davidpalma666/Miniscope-v4-Wire-Free-FORK/Miniscope-v4-Wire-Free-KiCad/KiCad/Miniscope-v4-Wire-Free BOM 1st COMPLETE.xlsx

Miniscope-v4-Wire-Free BOM
 | Qty | Reference | Value | Description | MPN | OEPS PN | Footprint
 | 9 | C1, C2, C6, C7, C26, C35, C50-C52 | 10uF | SMD CER 0402 10uF 10V ±20% X5R (OEPS M01 014) | CL05A106MP5NUNC | OEPS010038 | .Capacitor:C_0402_1005Metric_L
 | 2 | C14, C37 | 1uF | SMD CER 0201 1uF 16V ±20% X5R (OEPS M01 009) | CL03A105MO3NRNH | OEPS010036 | .Capacitor:C_0201_0603Metric_L
 | 1 | C16 | 4.7nF 100V | SMD CER 0603 4.7nF 100V ±10% X7R | 885012206112 _ | OEPS010014 | .Capacitor:C_0603_1608Metric_L
 | 3 | C17, C29, C36 | 4.7uF | SMD CER 0201 4.7UF 6.3V ±20% X5R CASE SIZE CONTAINS MAX VOLTAGE!! | GRM035R60J475ME15D https://www.digikey.pt/en/products/detail/murata-electronics/GRM035R60J475ME15D/5877393 | TBD | .Capacitor:C_0201_0603Metric_L
 | 2 | C18, C20 | 22pF | SMD CER 0201 27pF 50V ±2% C0G, NP0 | GRM0335C1H270GA01D | OEPS010029 | .Capacitor:C_0201_0603Metric_L
 | 2 | C3, C4 | 10pF | SMD CER 0201 10pF 50V ±5% C0G | GRM0335C1H100JA01J | OEPS010060 | .Capacitor:C_0201_0603Metric_L
 | 5 | C5, C11-C13, C15 | 2.2uF | SMD CER 0201 2.2uF 10V ±20% X5R (OEPS J05 004A) | CM03X5R225M10AH | OEPS010042 | .Capacitor:C_0201_0603Metric_L
 | 22 | C9, C10, C19, C22-C25, C27, C28, C30, C38, C40-C49, C53 | 0.1uF | SMD CER 0201 100nF 25V ±10% X5R (OEPS M01 007) | GRM033R61E104KE14J | OEPS010035 | .Capacitor:C_0201_0603Metric_L
 | 1 | D1 | LXZ1-PR01 | LED SMD Blue 450nm 500mA (OEPS J05 012) | LXZ1-PR01 | OEPS030021 | .LED:LED_LXZ1_PR01_L
 | 2 | D2, D3 | LED_Small_ALT | !!! Wich LED PN? | !!! Wich LED PN? | !!! TBD | .LED:LED_SC80X160X65L40L
 | 1 | J1 | 475710001 | CONN MICRO SD CARD PUSH-PULL R/A | 0475710001 https://www.digikey.com/en/products/detail/molex/0475710001/3262277 | TBD | .Connector:0475710001
 | 1 | J2 | Conn_01x04 | !!! Which connector PN? | !!! Which connector PN? | !!! TBD | .Connector:1x4_USB
 | 1 | J3 | Conn_01x04 | CONN FFC BOTTOM 4POS 0.5MM R/A | FH19C-4S-0.5SH(10) | TBD | .Connector:FH19C-4S-0.5SH(10)
 | 23 | J4-J12, J14-J27 | Conn_01x01 | !!! Which connector PN? | !!! Which connector PN? | !!! TBD | .Connector:Conn_1x1_700_Circular_Pad
 | 2 | L1, L5 | 10uH | FIXED IND 10UH 400MA 2.7 OHM SMD | 0805CT-103EKFS https://www.digikey.pt/en/products/detail/delta-electronics-components/0805CT-103EKFS/9764104 | TBD | .Capacitor:C_0805_2012Metric_L
 | 1 | L2 | 4.7uH | FIXED INDUCTOR SMD 4.7uH 750mA 260mΩ | !! CIG21L4R7MNE Obsolete; to select a new one | TBD !! OEPS040017 Obsolete | .Capacitor:C_0805_2012Metric_L
 | 1 | L3 | L_Small | !!! Wich L value? | !!! Wich L value? | !!! TBD | .Inductor:L_0603_1608Metric_L
 | 1 | L4 | BLM18PG471SN1D | FERRITE BEAD SMD 470Ω 1A 200mΩ (OEPS J05 017) | BLM18PG471SN1D | OEPS040014 | .Inductor:L_0603_1608Metric_L
 | 1 | Q1 | NTK3134NT1G | Power MOSFET | NTK3134NT1G | TBD | .Transistor:TRXSOFL3P40_120X120X55L29X21L
 | 1 | Q2 | MMBT3904LP-7B | BJT NPN 40V 0.2A (OEPS J05 019) | MMBT3904LP-7B | OEPS060014 | .Transistor:TRXDFN3_101X61X53L25X15N
 | 2 | R1, R17 | 25K | !!! 25k with no components; closest value 24.9k | !!! RC0201FR-0724K9L https://www.digikey.com/en/products/detail/yageo/RC0201FR-0724K9L/3202396 | !!! TBD | .Resistor:R_0201_0603Metric_ERJ_L
 | 1 | R10 | 2K | SMD 0201 2kΩ ±1% 0.050W (OEPS Q20 006, OEPS M01 021) | RC0201FR-072KL | OEPS020067 | .Resistor:R_0201_0603Metric_ERJ_L
 | 2 | R11, R19 | 1K | SMD 0201 1kΩ ±1% 0.050W (OEPS Q20 008) | RC0201FR-071KL | OEPS020065 | .Resistor:R_0201_0603Metric_ERJ_L
 | 1 | R12 | DNL | - | - | n.a. | .Resistor:R_0201_0603Metric_ERJ_L
 | 1 | R13 | 400K | !!! 400k with no components; closest value 402k | !!! ERJ-1GNF4023C https://www.digikey.com/en/products/detail/panasonic-electronic-components/ERJ-1GNF4023C/2036409 | !!! TBD | .Resistor:R_0201_0603Metric_ERJ_L
 | 3 | R14, R16, R20 | 100K | SMD 0201 100kΩ ±1% 0.050W (OEPS J05 022) | ERJ-1GNF1003C | OEPS020072 | .Resistor:R_0201_0603Metric_ERJ_L
 | 1 | R15 | 37K | !!! 37k with no components; closest value 37.4k | !!! ERJ-1GNF3742C https://www.digikey.com/en/products/detail/panasonic-electronic-components/ERJ-1GNF3742C/2036290 | !!! TBD | .Resistor:R_0201_0603Metric_ERJ_L
 | 1 | R18 | R_Small_US | !!! Wich R value? | !!! Wich R value? | !!! TBD | .Resistor:R_0201_0603Metric_ERJ_L
 | 1 | R2 | 1K8 | SMD 0201 1.8kΩ ±1% 0.050W (OEPS J05 024) | ERJ-1GNF1801C | OEPS020074 | .Resistor:R_0201_0603Metric_ERJ_L
 | 1 | R21 | 10K | SMD 0201 10kΩ ±1% 0.050W (OEPS J05 021) | ERJ-1GNF1002C | OEPS020071 | Custom:R_0201_0603Metric_ERJ_L
 | 1 | R22 | 47k5 | SMD 0201 47.5kΩ ±1% 0.050W (OEPS J05 025) | ERJ-1GNF4752C | OEPS020075 | Custom:R_0201_0603Metric_ERJ_L
 | 1 | R3 | 1.25M | 1.25M only witn non-standard package; 1.2M - as option | CRCW02011M20FNED https://www.digikey.com/en/products/detail/vishay-dale/CRCW02011M20FNED/8637988 | TBD | .Resistor:R_0201_0603Metric_ERJ_L
 | 1 | R4 | 2.05M | SMD 0201 2.05MΩ ±1% 0.050W | CRCW02012M05FNED https://www.digikey.com/en/products/detail/vishay-dale/CRCW02012M05FNED/10458998 | TBD | .Resistor:R_0201_0603Metric_ERJ_L
 | 1 | R5 | 1M | SMD 0201 1MΩ ±1% 0.050W | CRCW02011M00FNED https://www.digikey.com/en/products/detail/vishay-dale/CRCW02011M00FNED/1178507 | TBD | .Resistor:R_0201_0603Metric_ERJ_L
 | 1 | R6 | 649K | SMD 0201 649kΩ ±1% 0.050W | RC0201FR-07649KL https://www.digikey.com/en/products/detail/yageo/RC0201FR-07649KL/5280620 | TBD | .Resistor:R_0201_0603Metric_ERJ_L
 | 2 | R7, R8 | 2.2K | SMD 0201 2.2kΩ ±1% 0.050W | RC0201FR-072K2L https://www.digikey.com/en/products/detail/yageo/RC0201FR-072K2L/5280432 | TBD | .Resistor:R_0201_0603Metric_ERJ_L
 | 1 | R9 | 8.2K | SMD 0201 8.2kΩ ±1% 0.050W | ERJ-1GNF8201C https://www.digikey.com/en/products/detail/panasonic-electronic-components/ERJ-1GNF8201C/2036216 | TBD | .Resistor:R_0201_0603Metric_ERJ_L
 | 1 | SW1 | TL3780AF330QG | SWITCH TACTILE SPST-NO 0.05A 12V | TL3780AF330QG https://www.digikey.com/en/products/detail/e-switch/tl3780af330qg/6003168 | TBD | .Switch:SMD-Switch-3mmx2mm
 | 1 | U1 | LTC3554 | IC USB POWER MANAGER 20UTQFN | LTC3554EUD#PBF https://www.digikey.com/en/products/detail/analog-devices-inc/LTC3554EUD-PBF/2355199 | TBD | Package_DFN_QFN:QFN-20-1EP_3x3mm_P0.4mm_EP1.65x1.65mm
 | 1 | U2 | HV892 | IC LED DRIVER LENS 10WDFN | HV892K7-G https://www.digikey.com/en/products/detail/microchip-technology/HV892K7-G/4902801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 | TBD | .Package_SON:SON11P65_400X400X80L40X30T315X255L
 | 1 | U3 | LTC3218 | LED Driver 150mA (OEPS J1 022) | LTC3218EDDB#TRMPBF | OEPS080069 | .Package_SON:SON_11_P50_300X200X80L40X25T239X64L
 | 1 | U4 | MAX13030EETE+BGA | !!! Which component PN? | !!! Component's value doesn't allow to know PN; MAX13031; MAX13032; MAX13033; MAX13034; MAX13035 ?? | !!! TBD | Package_BGA:BGA-16_1.92x1.92mm_Layout4x4_P0.5mm
 | 1 | U5 | TSOP57438TT1 | IR Receiver Sensor 38.0kHz 40m Surface Mount | TSOP57438TT1 | OEPSJ1008 | .Package_SON:SON_4_P300_395X395X90L55X35L
 | 1 | U6 | ATSAMD51J20A-UUT-EFP | MCU 120MHZ 1024KB FLASH 64 | ATSAMD51J20A-UUT-EFP https://www.digikey.com/en/products/detail/microchip-technology/atsamd51j20a-uut-efp/11476389 | TBD | .Package_BGA:ATSAMD51J20A-UUT-EFP
 | 1 | U7 | NCP163AMX330TBG | LDO 3.3V 250mA (OEPS Z00 004) | NCP163AMX330TBG | OEPS080076 | .Package_QFN:UQFN_MCP1711
 | 1 | U8 | NOIP1SN0480A | !!! Which component? | !!! Component's value doesn't allow to know PN; NOIP1SN0480A-STI or NOIP1SN0480A-STI1 | !!! TBD | .Package_BGA:BGA88CP50_8X11_493X613X75B25
 | 1 | U9 | LMV321IDCKR | OPAMP GP 1 CIRCUIT (OEPS J05 030) | LMV321IDCKR | OEPS080068 | .Package_SOT:SOT_23-5P65_210X110L36X22L
 | 1 | Y2 | Crystal | Which Crystal PN? | Which Crystal PN? | TBD | Crystal:Crystal_SMD_MicroCrystal_CC8V-T1A-2Pin_2.0x1.2mm
