davidpalma666/Miniscope-v4-Wire-Free-FORK/Miniscope-v4-Wire-Free-KiCad/KiCad/Miniscope-v4-Wire-Free/Miniscope-v4-Wire-Free.kicad_pcb

## KiCad design Miniscope-v4-Wire-Free-KiCad/KiCad/Miniscope-v4-Wire-Free/Miniscope-v4-Wire-Free.kicad_pcb (2025-02-11)

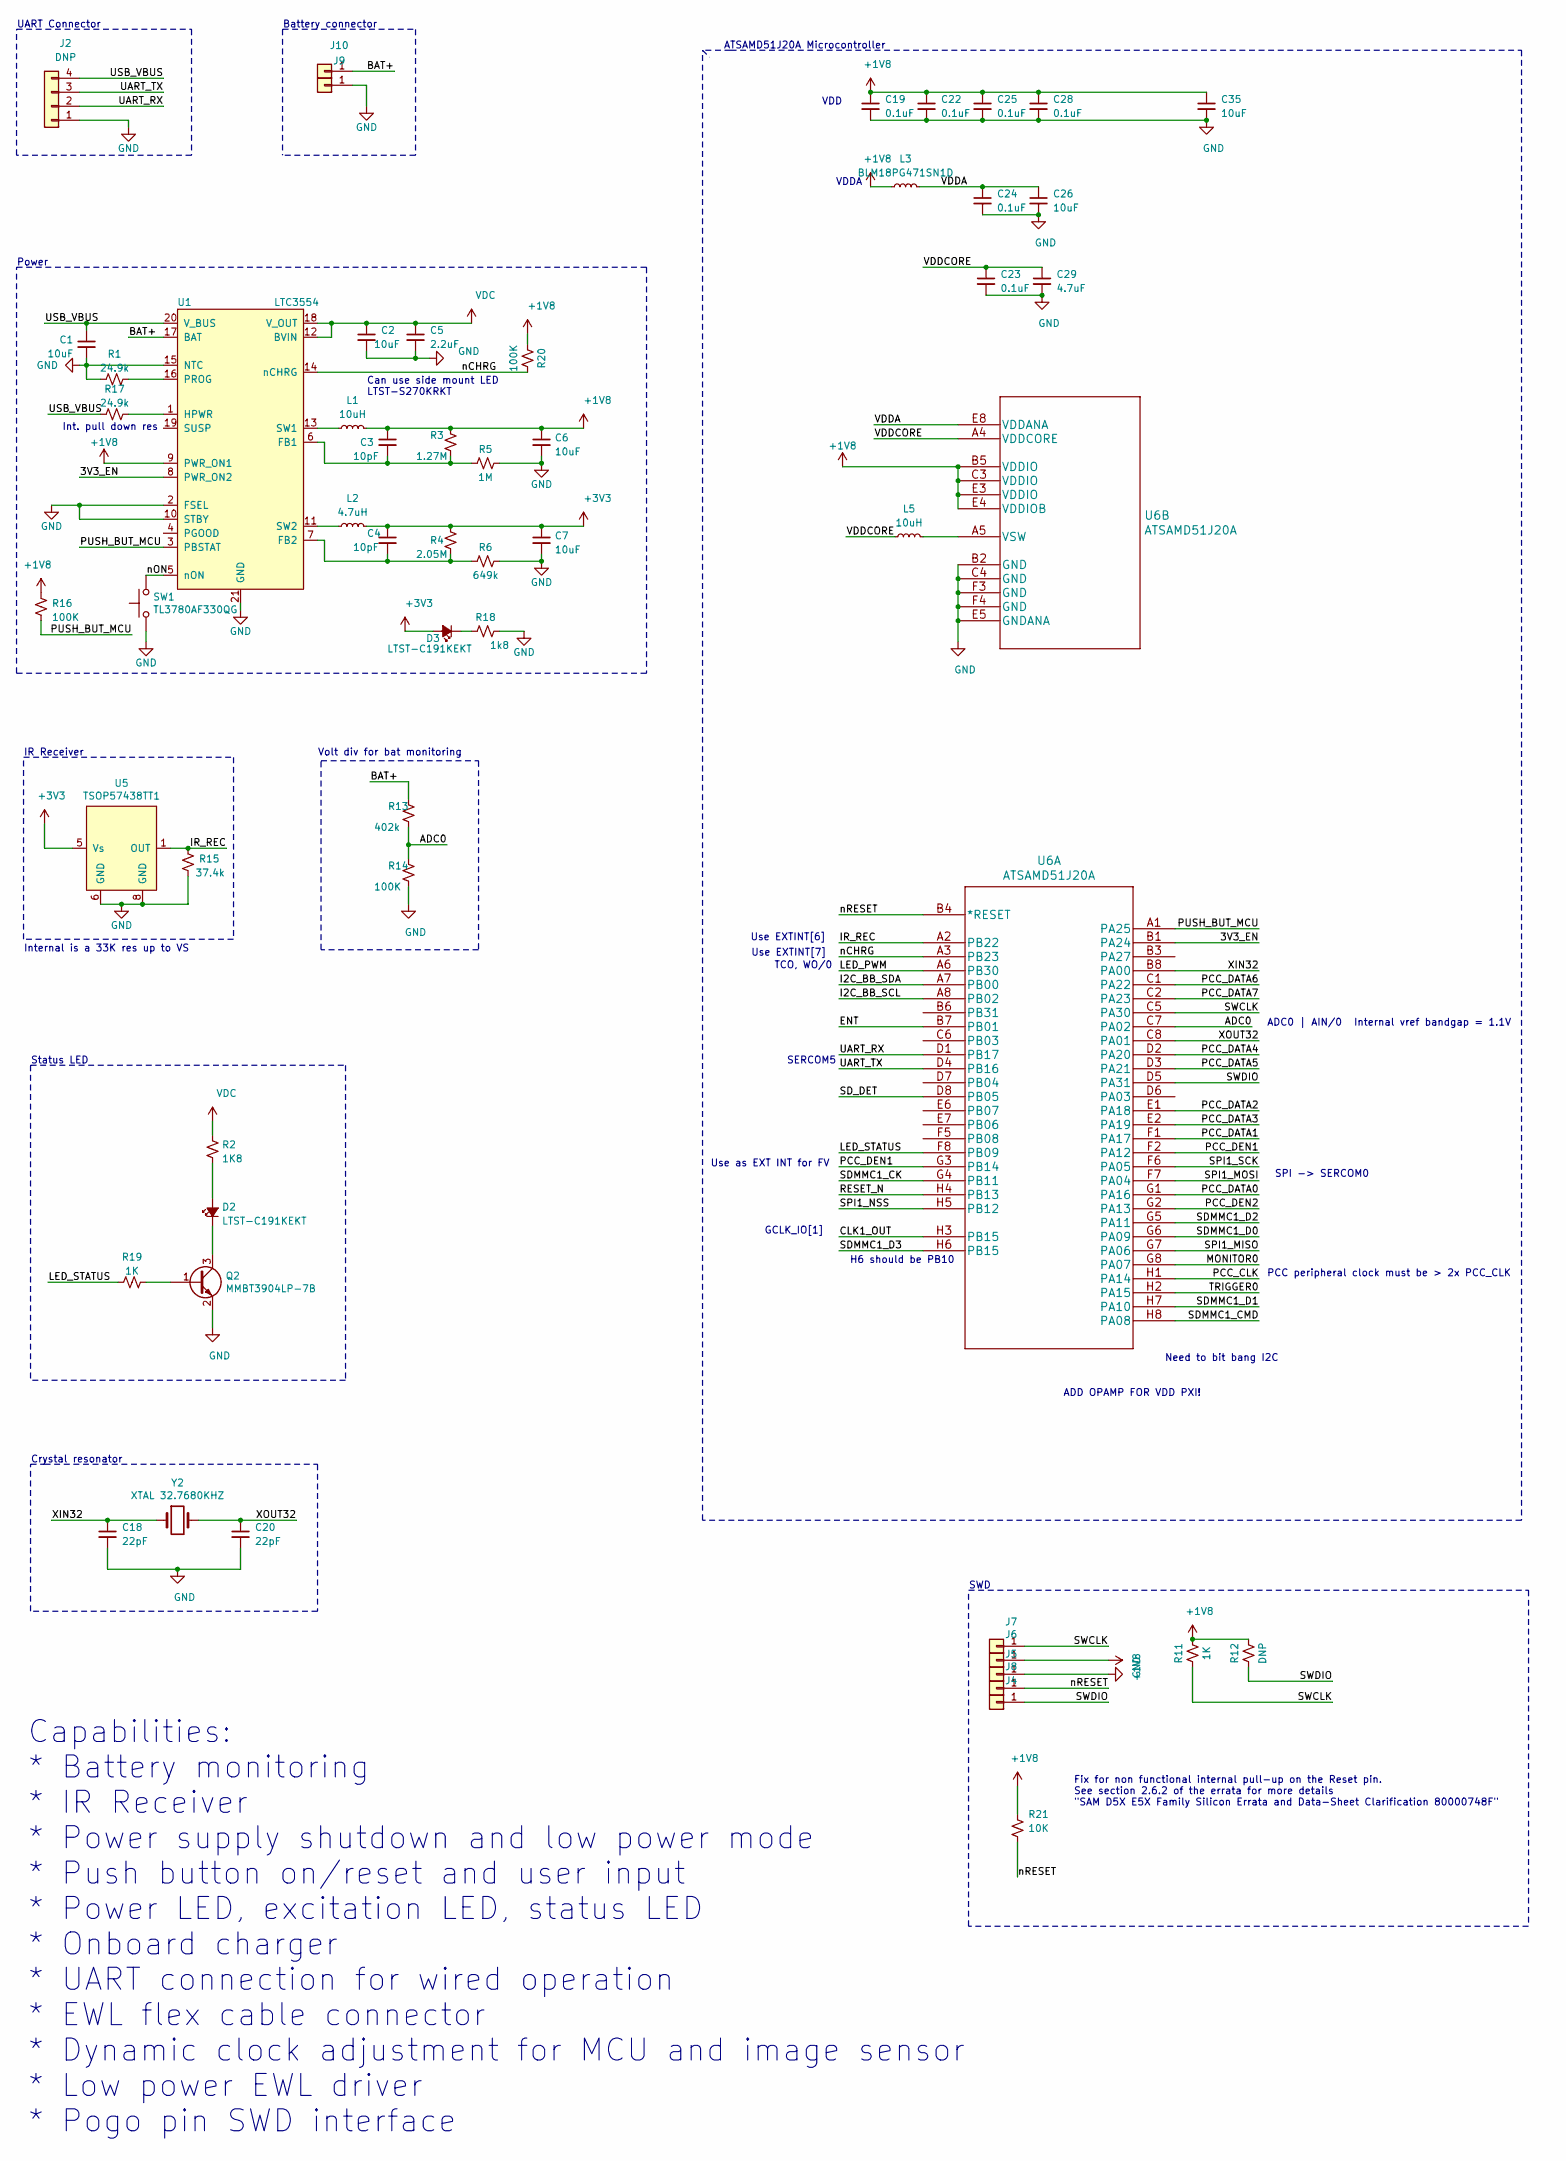
[picture p1: schematic Miniscope-v4-Wire-Free.kicad_sch, part in row 1, column 1]

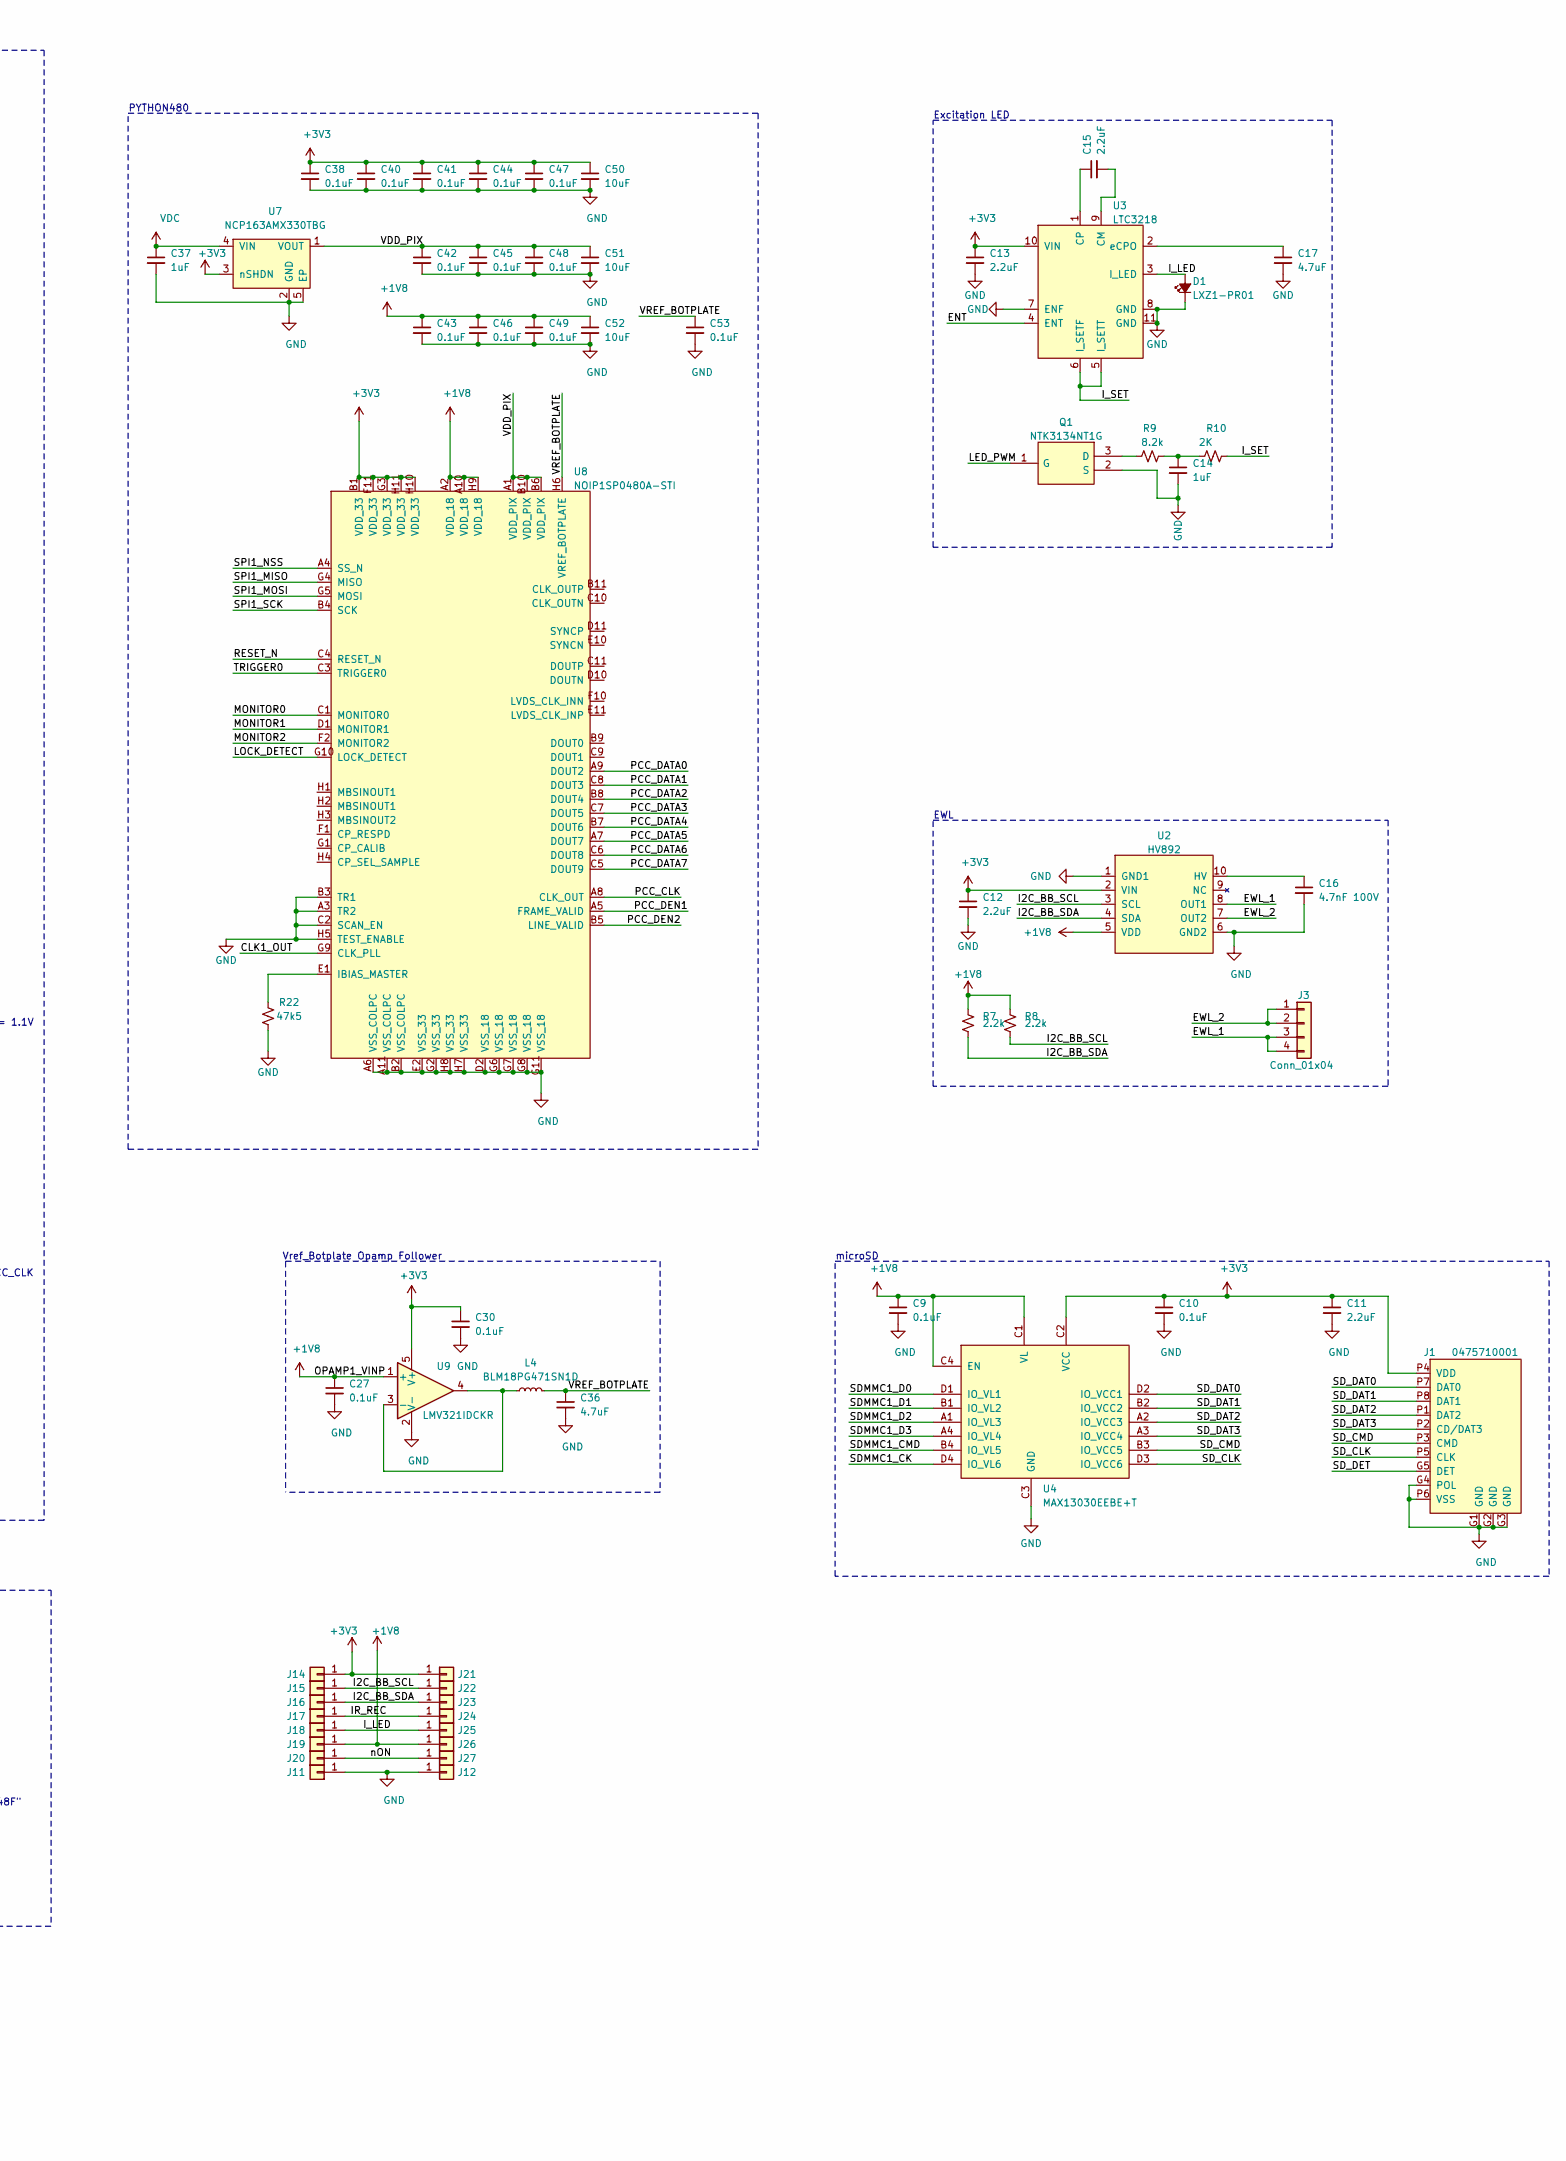
[picture p2: schematic Miniscope-v4-Wire-Free.kicad_sch, part in row 1, column 2]

Parts:
C1, C2, C6, C7, C26, C35, C50, C51, C52: 10uF; C_0402_1005Metric_L; MPN CL05A106MP5NUNC
C3, C4: 10pF; C_0201_0603Metric_L; MPN GRM0335C1H100JA01J
C5, C11, C12, C13, C15: 2.2uF; C_0201_0603Metric_L; MPN CM03X5R225M10AH
C9, C10, C19, C22, C23, C24, C25, C27, C28, C30, C38, C40, C41, C42, C43, C44, C45, C46, C47, C48, C49, C53: 0.1uF; C_0201_0603Metric_L; MPN GRM033R61E104KE14J
C14, C37: 1uF; C_0201_0603Metric_L; MPN CL03A105MO3NRNH
C16: 4.7nF 100V; C_0603_1608Metric_L; MPN 885012206112
C17, C29, C36: 4.7uF; C_0201_0603Metric_L; MPN GRM035R60J475ME15D
C18, C20: 22pF; C_0201_0603Metric_L; MPN GRM0335C1H270GA01D
D1: LXZ1-PR01; LED_LXZ1_PR01_L; MPN LXZ1-PR01
D2, D3: LTST-C191KEKT; LED_SC80X160X65L40L; MPN LTST-C191KEKT
J1: 0475710001; MPN 0475710001
J2: DNP; 1x4_USB; MPN n.a.
J3: Conn_01x04; FH19C-4S-0.5SH(10); MPN FH19C-4S-0.5SH(10)
J4, J5, J6, J7, J8, J9, J10, J11, J12, J14, J15, J16, J17, J18, J19, J20, J21, J22, J23, J24, J25, J26, J27: DNP; Conn_1x1_700_Circular_Pad; MPN n.a.
L1, L5: 10uH; C_0805_2012Metric_L; MPN MLZ1608N100LT000
L2: 4.7uH; C_0805_2012Metric_L; MPN MLP2012S4R7MT0S1
L3, L4: BLM18PG471SN1D; L_0603_1608Metric_L; MPN BLM18PG471SN1D
Q1: NTK3134NT1G; TRXSOFL3P40_120X120X55L29X21L; Manufacturer_Part_Number NTK3134NT1G; Mouser Part Number 863-NTK3134NT1G
Q2: MMBT3904LP-7B; TRXDFN3_101X61X53L25X15N; MPN MMBT3904LP-7B
R1, R17: 24.9k; R_0201_0603Metric_ERJ_L; MPN CRCW020124K9FNED
R2: 1K8; R_0201_0603Metric_ERJ_L; MPN ERJ-1GNF1801C
R3: 1.27M; R_0201_0603Metric_ERJ_L; MPN CRCW02011M27FNED
R4: 2.05M; R_0201_0603Metric_ERJ_L; MPN CRCW02012M05FNED
R5: 1M; R_0201_0603Metric_ERJ_L; MPN CRCW02011M00FNED
R6: 649k; R_0201_0603Metric_ERJ_L; MPN RC0201FR-07649KL
R7, R8: 2.2k; R_0201_0603Metric_ERJ_L; MPN RC0201FR-072K2L
R9: 8.2k; R_0201_0603Metric_ERJ_L; MPN ERJ-1GNF8201C
R10: 2K; R_0201_0603Metric_ERJ_L; MPN RC0201FR-072KL
R11, R19: 1K; R_0201_0603Metric_ERJ_L; MPN RC0201FR-071KL
R12: DNP; R_0201_0603Metric_ERJ_L; MPN n.a.
R13: 402k; R_0201_0603Metric_ERJ_L; MPN ERJ-1GNF4023C
R14, R16, R20: 100K; R_0201_0603Metric_ERJ_L; MPN ERJ-1GNF1003C
R15: 37.4k; R_0201_0603Metric_ERJ_L; MPN ERJ-1GNF3742C
R18: 1k8; R_0201_0603Metric_ERJ_L; MPN ERJ-1GNF1801C
R21: 10K; R_0201_0603Metric_ERJ_L; MPN ERJ-1GNF1002C
R22: 47k5; R_0201_0603Metric_ERJ_L; MPN ERJ-1GNF4752C
SW1: TL3780AF330QG; SMD-Switch-3mmx2mm; MPN TL3780AF330QG
U1: LTC3554; QFN-20-1EP_3x3mm_P0.4mm_EP1.65x1.65mm; MPN LTC3554EUD#PBF
U2: HV892; SON11P65_400X400X80L40X30T315X255L; MPN HV892K7-G
U3: LTC3218; SON_11_P50_300X200X80L40X25T239X64L; MPN LTC3218EDDB#TRMPBF
U4: MAX13030EEBE+T; BGA-16_1.92x1.92mm_Layout4x4_P0.5mm; MPN MAX13030EEBE+T
U5: TSOP57438TT1; SON_4_P300_395X395X90L55X35L; MPN TSOP57438TT1
U6: ATSAMD51J20A; ATSAMD51J20A-UUT-EFP; MPN ATSAMD51J20A-UUT-EFP
U7: NCP163AMX330TBG; UQFN_MCP1711; MPN NCP163AMX330TBG
U8: NOIP1SP0480A-STI; BGA88CP50_8X11_493X613X75B25; MPN NOIP1SP0480A-STI
U9: LMV321IDCKR; SOT_23-5P65_210X110L36X22L; MPN LMV321IDCKR
Y2: XTAL 32.7680KHZ; Crystal_SMD_MicroCrystal_CC8V-T1A-2Pin_2.0x1.2mm; MPN 9HT11-32.768KBZF-T

Connections:
+1V8: C3.1, C6.1, C9.1, C19.1, C22.1, C25.1, C27.1, C28.1, C35.1, C43.1, C46.1, C49.1, C52.1, J6.1, J19.1, J26.1, L1.2, L3.1, R3.1, R7.1, R8.1, R11.1, R12.1, R16.1, R20.2, R21.1, U1.9 (PWR_ON1), U2.5 (VDD), U4.C1 (VL), U4.C4 (EN), U6.B5 (VDDIO), U6.C3 (VDDIO), U6.E3 (VDDIO), U6.E4 (VDDIOB), U8.A2 (VDD_18), U8.A10 (VDD_18), U8.H9 (VDD_18), U9.1 (+)
+3V3: C4.1, C7.1, C10.1, C11.1, C12.1, C13.1, C30.1, C38.1, C40.1, C41.1, C44.1, C47.1, C50.1, D3.2 (A), J1.P4 (VDD), J14.1, J21.1, L2.2, R4.1, U2.2 (VIN), U3.10 (VIN), U4.C2 (VCC), U5.5 (Vs), U7.3 (nSHDN), U8.B1 (VDD_33), U8.F11 (VDD_33), U8.G3 (VDD_33), U8.H10 (VDD_33), U8.H11 (VDD_33), U9.5 (V+)
/3V3_EN: U1.8 (PWR_ON2), U6.B1 (PA24)
/ADC0: R13.2, R14.1, U6.C7 (PA02)
/BAT+: J10.1, R13.1, U1.17 (BAT)
/CLK1_OUT: U6.H3 (PB15), U8.G9 (CLK_PLL)
/ENT: U3.4 (ENT), U6.B7 (PB01)
/EWL_1: J3.3, J3.4, U2.8 (OUT1)
/EWL_2: J3.1, J3.2, U2.7 (OUT2)
/I2C_BB_SCL: J15.1, J22.1, R8.2, U2.3 (SCL), U6.A8 (PB02)
/I2C_BB_SDA: J16.1, J23.1, R7.2, U2.4 (SDA), U6.A7 (PB00)
/IR_REC: J17.1, J24.1, R15.1, U5.1 (OUT), U6.A2 (PB22)
/I_LED: D1.A, J18.1, J25.1, U3.3 (I_LED)
/I_SET: R10.1, U3.5 (I_SETT), U3.6 (I_SETF)
/LED_PWM: Q1.1 (G), U6.A6 (PB30)
/LED_STATUS: R19.2, U6.F8 (PB09)
/LOCK_DETECT: U8.G10 (LOCK_DETECT)
/MONITOR0: U6.G8 (PA07), U8.C1 (MONITOR0)
/MONITOR1: U8.D1 (MONITOR1)
/MONITOR2: U8.F2 (MONITOR2)
/PCC_CLK: U6.H1 (PA14), U8.A8 (CLK_OUT)
/PCC_DATA0: U6.G1 (PA16), U8.A9 (DOUT2)
/PCC_DATA1: U6.F1 (PA17), U8.C8 (DOUT3)
/PCC_DATA2: U6.E1 (PA18), U8.B8 (DOUT4)
/PCC_DATA3: U6.E2 (PA19), U8.C7 (DOUT5)
/PCC_DATA4: U6.D2 (PA20), U8.B7 (DOUT6)
/PCC_DATA5: U6.D3 (PA21), U8.A7 (DOUT7)
/PCC_DATA6: U6.C1 (PA22), U8.C6 (DOUT8)
/PCC_DATA7: U6.C2 (PA23), U8.C5 (DOUT9)
/PCC_DEN1: U6.F2 (PA12), U6.G3 (PB14), U8.A5 (FRAME_VALID)
/PCC_DEN2: U6.G2 (PA13), U8.B5 (LINE_VALID)
/PUSH_BUT_MCU: R16.2, U1.3 (PBSTAT), U6.A1 (PA25)
/RESET_N: U6.H4 (PB13), U8.C4 (RESET_N)
/SDMMC1_CK: U4.D4 (IO_VL6), U6.G4 (PB11)
/SDMMC1_CMD: U4.B4 (IO_VL5), U6.H8 (PA08)
/SDMMC1_D0: U4.D1 (IO_VL1), U6.G6 (PA09)
/SDMMC1_D1: U4.B1 (IO_VL2), U6.H7 (PA10)
/SDMMC1_D2: U4.A1 (IO_VL3), U6.G5 (PA11)
/SDMMC1_D3: U4.A4 (IO_VL4), U6.H6 (PB15)
/SD_CLK: J1.P5 (CLK), U4.D3 (IO_VCC6)
/SD_CMD: J1.P3 (CMD), U4.B3 (IO_VCC5)
/SD_DAT0: J1.P7 (DAT0), U4.D2 (IO_VCC1)
/SD_DAT1: J1.P8 (DAT1), U4.B2 (IO_VCC2)
/SD_DAT2: J1.P1 (DAT2), U4.A2 (IO_VCC3)
/SD_DAT3: J1.P2 (CD/DAT3), U4.A3 (IO_VCC4)
/SD_DET: J1.G5 (DET), U6.D8 (PB05)
/SPI1_MISO: U6.G7 (PA06), U8.G4 (MISO)
/SPI1_MOSI: U6.F7 (PA04), U8.G5 (MOSI)
/SPI1_NSS: U6.H5 (PB12), U8.A4 (SS_N)
/SPI1_SCK: U6.F6 (PA05), U8.B4 (SCK)
/SWCLK: J7.1, R11.2, U6.C5 (PA30)
/SWDIO: J4.1, R12.2, U6.D5 (PA31)
/TRIGGER0: U6.H2 (PA15), U8.C3 (TRIGGER0)
/UART_RX: J2.2, U6.D1 (PB17)
/UART_TX: J2.3, U6.D4 (PB16)
/USB_VBUS: C1.1, J2.4, R17.2, U1.20 (V_BUS)
/VDDA: C24.1, C26.1, L3.2, U6.E8 (VDDANA)
/VDDCORE: C23.1, C29.1, L5.1, U6.A4 (VDDCORE)
/VDD_PIX: C42.1, C45.1, C48.1, C51.1, U7.1 (VOUT), U8.A1 (VDD_PIX), U8.B6 (VDD_PIX), U8.B10 (VDD_PIX)
/VREF_BOTPLATE: C36.1, C53.1, L4.2, U8.H6 (VREF_BOTPLATE)
/XIN32: C18.1, U6.B8 (PA00), Y2.1
/XOUT32: C20.1, U6.C8 (PA01), Y2.2
/nCHRG: R20.1, U1.14 (nCHRG), U6.A3 (PB23)
/nON: J20.1, J27.1, SW1.2, U1.5 (nON)
/nRESET: J8.1, R21.2, U6.B4 (*RESET)
GND: C1.2, C2.2, C5.2, C6.2, C7.2, C9.2, C10.2, C11.2, C12.2, C13.2, C14.2, C16.2, C17.2, C18.2, C19.2, C20.2, C22.2, C23.2, C24.2, C25.2, C26.2, C27.2, C28.2, C29.2, C30.2, C35.2, C36.2, C37.2, C38.2, C40.2, C41.2, C42.2, C43.2, C44.2, C45.2, C46.2, C47.2, C48.2, C49.2, C50.2, C51.2, C52.2, C53.2, D1.C, J1.G1 (GND), J1.G2 (GND), J1.G3 (GND), J1.G4 (POL), J1.P6 (VSS), J2.1, J5.1, J9.1, J11.1, J12.1, Q1.2 (S), Q2.2 (E), R1.2, R5.1, R6.1, R14.2, R15.2, R18.1, R22.2, SW1.1, U1.2 (FSEL), U1.10 (STBY), U1.15 (NTC), U1.21 (GND), U2.1 (GND1), U2.6 (GND2), U3.7 (ENF), U3.8 (GND), U3.11 (GND), U4.C3 (GND), U5.6 (GND), U5.8 (GND), U6.B2 (GND), U6.C4 (GND), U6.E5 (GNDANA), U6.F3 (GND), U6.F4 (GND), U7.2 (GND), U7.5 (EP), U8.A3 (TR2), U8.A6 (VSS_COLPC), U8.A11 (VSS_COLPC), U8.B2 (VSS_COLPC), U8.B3 (TR1), U8.C2 (SCAN_EN), U8.D2 (VSS_18), U8.E2 (VSS_33), U8.G2 (VSS_33), U8.G6 (VSS_18), U8.G7 (VSS_18), U8.G8 (VSS_18), U8.G11 (VSS_18), U8.H5 (TEST_ENABLE), U8.H7 (VSS_33), U8.H8 (VSS_33), U9.2 (V-)
unnamed: C3.2, R3.2, R5.2, U1.6 (FB1)
unnamed: C4.2, R4.2, R6.2, U1.7 (FB2)
unnamed: C14.1, R9.1, R10.2
unnamed: C15.1, U3.1 (CP)
unnamed: C15.2, U3.9 (CM)
unnamed: C16.1, U2.10 (HV)
unnamed: C17.1, U3.2 (eCPO)
unnamed: D2.1 (K), Q2.3 (C)
unnamed: D2.2 (A), R2.1
unnamed: D3.1 (K), R18.2
unnamed: L1.1, U1.13 (SW1)
unnamed: L2.1, U1.11 (SW2)
unnamed: L4.1, U9.3 (-), U9.4
unnamed: L5.2, U6.A5 (VSW)
unnamed: Q1.3 (D), R9.2
unnamed: Q2.1 (B), R19.1
unnamed: R1.1, U1.16 (PROG)
unnamed: R17.1, U1.1 (HPWR)
unnamed: R22.1, U8.E1 (IBIAS_MASTER)
VDC: C2.1, C5.1, C37.1, R2.2, U1.12 (BVIN), U1.18 (V_OUT), U7.4 (VIN)

Notes on the sheet:
Internal is a 33K res up to VS
Need to bit bang I2C
Fix for non functional internal pull-up on the Reset pin. See section 2.6.2 of the errata for more details "SAM D5X E5X Family Silicon Errata and Data-Sheet Clarification 80000748F"
Crystal resonator
Use as EXT INT for FV
SERCOM5
Excitation LED
Vref_Botplate Opamp Follower
H6 should be PB10
PCC peripheral clock must be > 2x PCC_CLK
Power
Internal vref bandgap = 1.1V
IR Receiver
UART Connector
Use EXTINT[7]
SPI -> SERCOM0
Can use side mount LED LTST-S270KRKT
Int. pull down res
EWL
ADC0 | AIN/0
VDD
Capabilities: * Battery monitoring * IR Receiver * Power supply shutdown and low power mode * Push button on/reset and user input * Power LED, excitation LED, status LED * Onboard charger * UART connection for wired operation * EWL flex cable connector * Dynamic clock adjustment for MCU and image s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
SWD
TCO, WO/0
Status LED
Volt div for bat monitoring
Battery connector
VDDA
ADD OPAMP FOR VDD PXI!
PYTHON480
Use EXTINT[6]
GCLK_IO[1]
ATSAMD51J20A Microcontroller
microSD

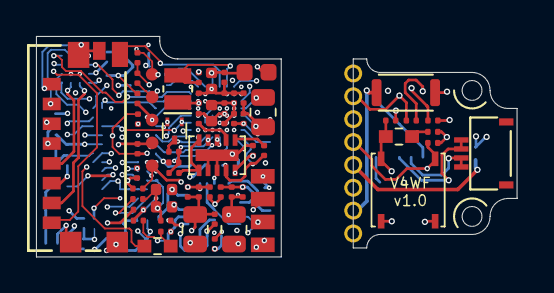
[picture p3: board Miniscope-v4-Wire-Free.kicad_pcb from above]

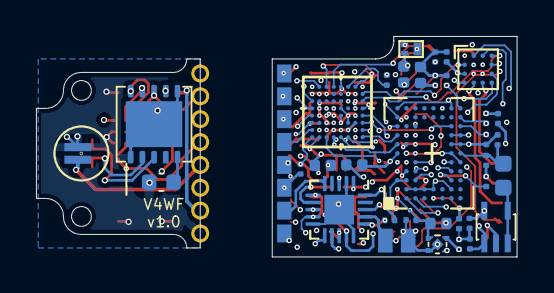
[picture p4: board Miniscope-v4-Wire-Free.kicad_pcb from below]

Board: 6 copper layers, 13.6 x 12.2 mm, 117 parts (44 on the bottom side), 83 nets.

Other parts of the board:
Mount: Conn_1x1_700_Circular_Pad
Mount#2: Conn_1x1_700_Circular_Pad
