davidpalma666/Miniscope-v4-Wire-Free-FORK/(commit log)

2024-07-15 My Miniscope-v4-Wire-Free Fork
    - components with new fields: MPN & OEPS PN
    - almost all components with these new fields filled in
    - some still missing: waiting new codes to be emitted
    [Miniscope-v4-Wire-Free BOM 1st COMPLETE.xlsx, Miniscope-v4-Wire-Free OEPS NEW CORRECTED.xlsx, Miniscope-v4-Wire-Free OEPS RETURNED BACK.xlsx, Miniscope-v4-Wire-Free-BOM FS OLD ONE.xlsx, Miniscope-v4-Wire-Free.csv, Miniscope-v4-Wire-Free.kicad_pcb, Miniscope-v4-Wire-Free.kicad_sch]
2024-07-29 final v4
    [Miniscope-v4-Wire-Free BOM.xlsx, Miniscope-v4-Wire-Free.csv, Miniscope-v4-Wire-Free.kicad_sch]
2025-02-11 synchronizing with master version @11022025
    [Miniscope-v4-Wire-Free.kicad_pcb, Miniscope-v4-Wire-Free.kicad_sch, Miniscope-v4-Wire-Free.sch]
