davidpalma666/Miniscope-v4-Wire-Free-FORK/(notices)

Notices in the files:
parts and their libraries:
Copyright 2016 Accelerated Designs. All rights reserved.
